jedi101/mailnotifier/README.md

# Mailnotifier

## What is Mailnotifier?
Mailnotifier is a smart mailbox extension that notifies you when you get mail.

### For documentation head over to our:
### [Mailnotifier documentation](https://iot-lab-minden.github.io/mailnotifier/)
