jedi101/mailnotifier/docs/_coverpage.md

# Mailnotifier
### ... make postboxes smart again ...
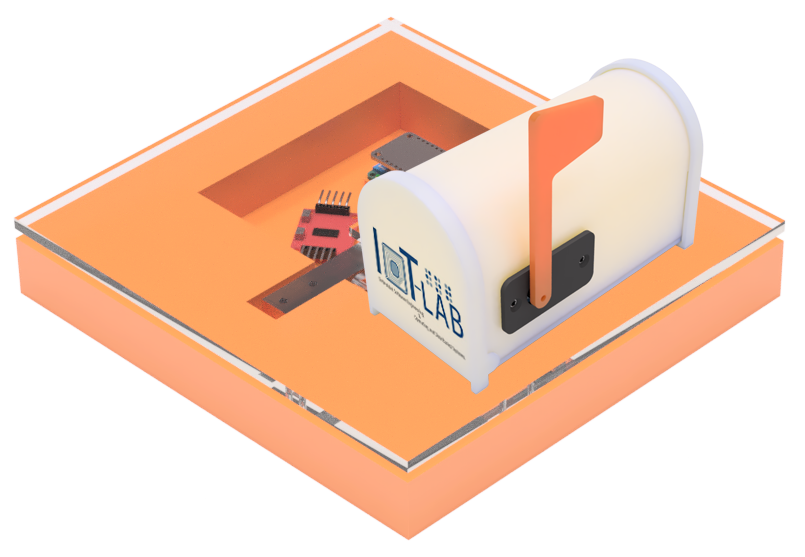
[picture p1: docs/images/coverimage_small.png]


[Overview](#main)
[Used Hardware](https://iot-lab-minden.github.io/mailnotifier/#/?id=used-hardware)
[GitHub](https://github.com/IoT-Lab-Minden/mailnotifier)
