jedi101/mailnotifier/docs/Diagrams/RequirementsDiagram.pdf

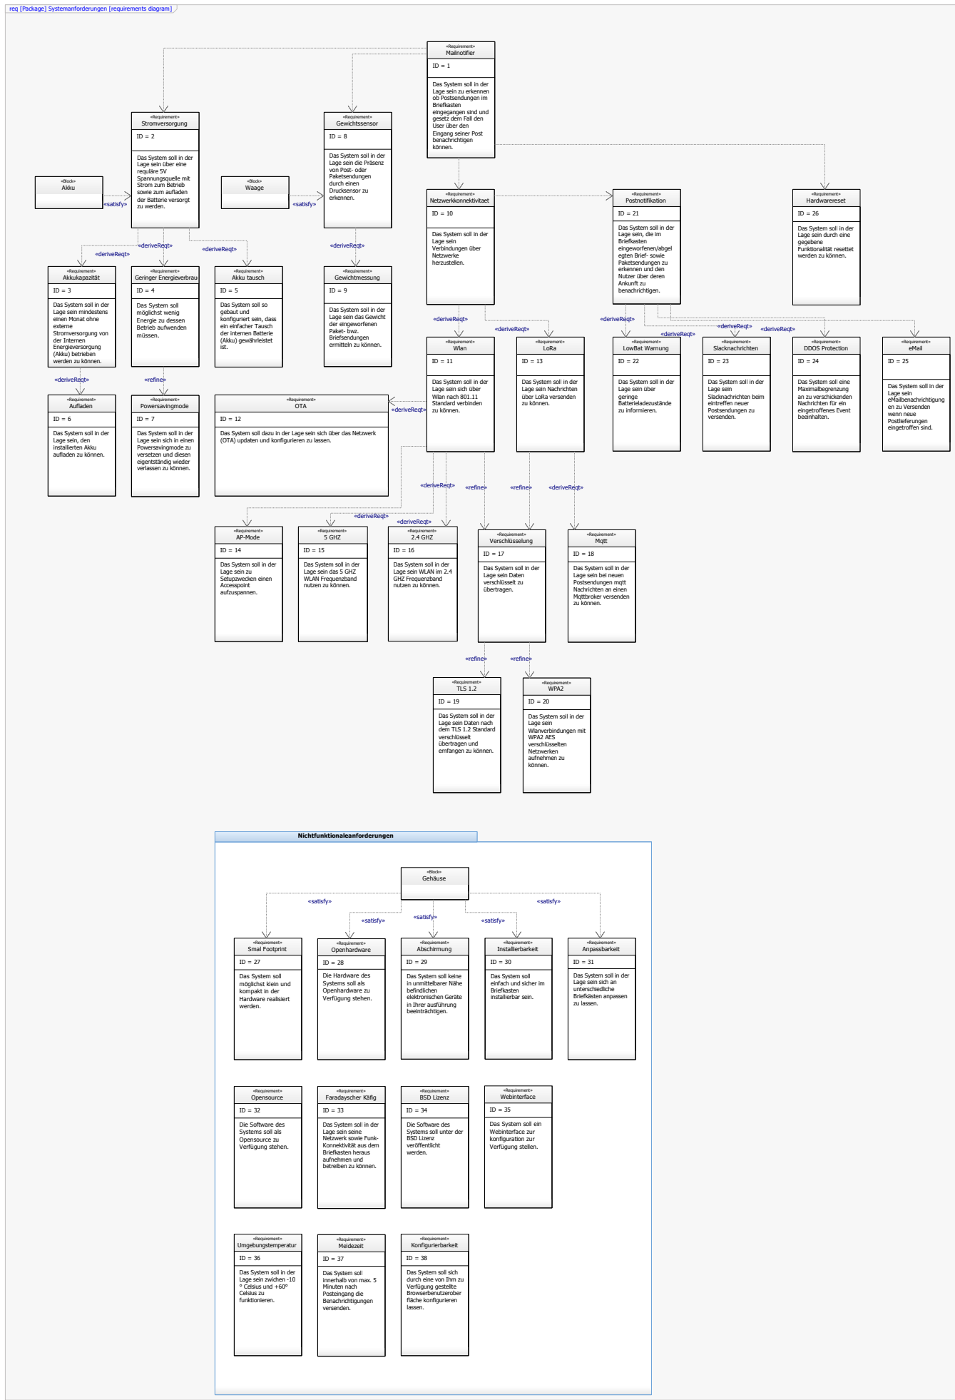
[picture p2: figure]
req [Package] Systemanforderungen [requirements diagram]; Postnotifikation; «Requirement»; Das System soll in der Lage sein, die im Briefkasten eingeworfenen/abgel egten Brief- sowie Paketsendungen zu erkennen und den Nutzer über deren Ankunft zu benachrichtigen.; Nichtfunktionaleanforderungen; Openhardware; Die Hardware des Systems soll als Openhardware zu Verfügung stehen.; Smal Footprint; Das System soll möglichst klein und kompakt in der Hardware realisiert werden.; Abschirmung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

Das System soll dazu in der Lage sein sich über das Netzwerk (OTA) updaten und konfigurieren zu lassen.
