jedi101/mailnotifier/docs/datasheets/feather_fabprint.png

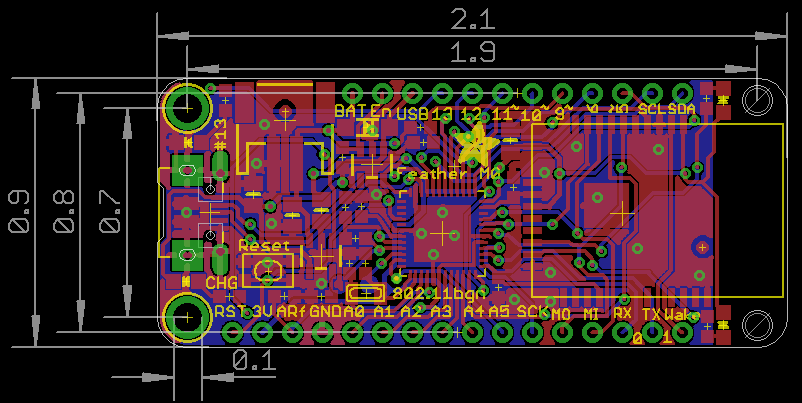
docs/datasheets/feather_fabprint.png
