jedi101/mailnotifier/docs/images/Adafruit-Feather-M0-WiFi---.png

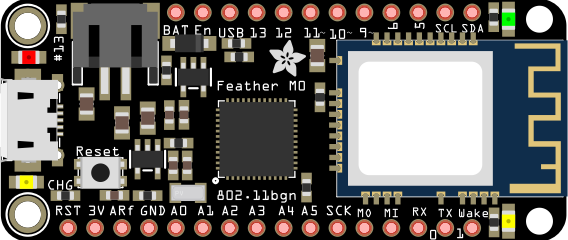
docs/images/Adafruit-Feather-M0-WiFi---.png
