jedi101/mailnotifier/docs/images/coverimage.png

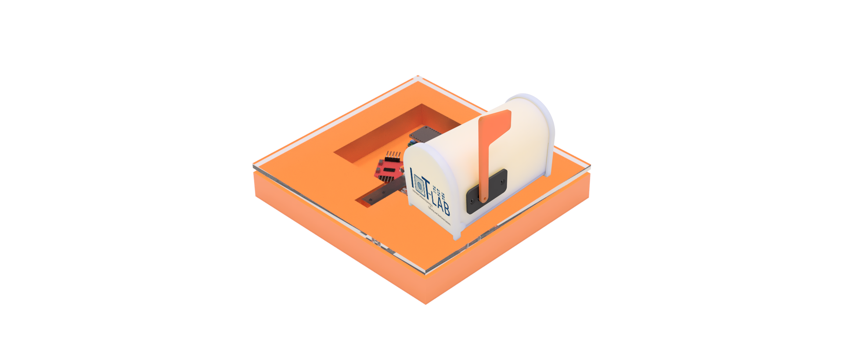
docs/images/coverimage.png
