jedi101/mailnotifier/docs/images/Download3.png

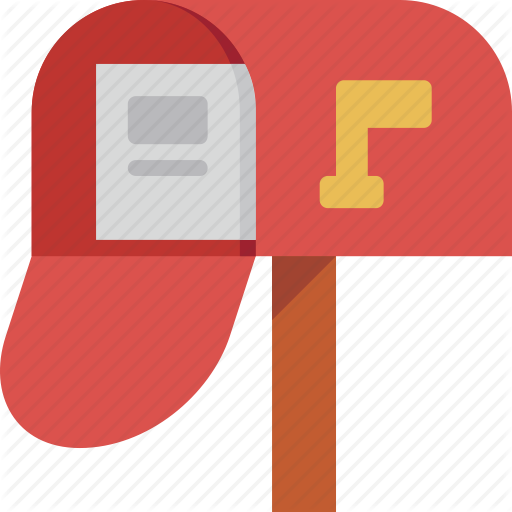
docs/images/Download3.png
