jedi101/mailnotifier/docs/images/HX711_Load_cell_amplifier.png

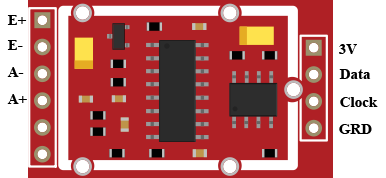
docs/images/HX711_Load_cell_amplifier.png
