jedi101/mailnotifier/docs/images/LoadCell.png

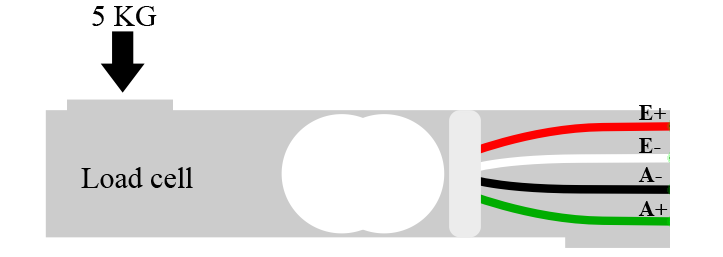
docs/images/LoadCell.png
