jedi101/mailnotifier/docs/images/mailnotifier_receiver.png

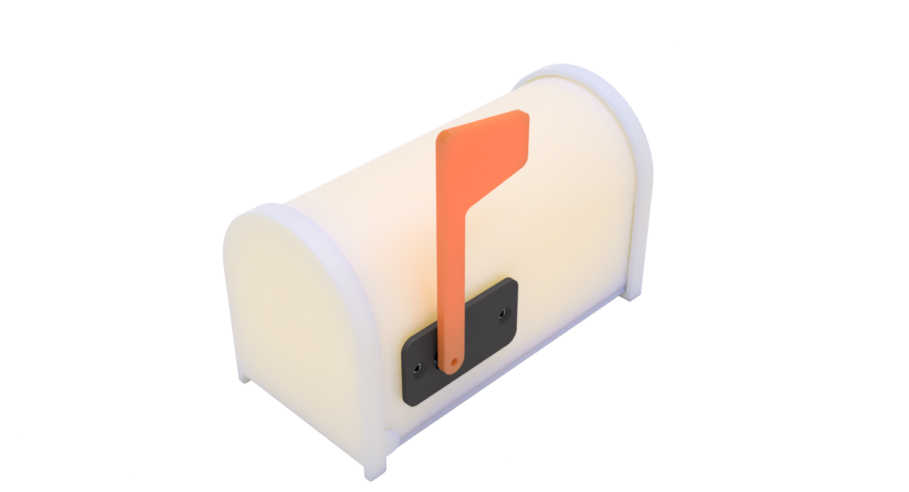
docs/images/mailnotifier_receiver.png
