jedi101/mailnotifier/docs/images/mailnotifierAnsicht1.png

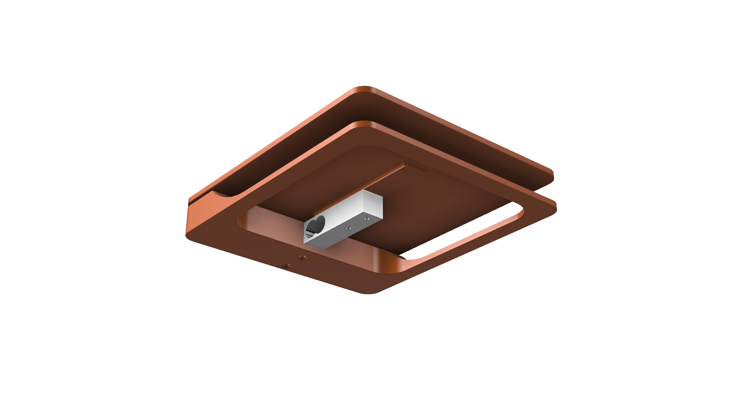
docs/images/mailnotifierAnsicht1.png
