jedi101/mailnotifier/docs/images/mailnotifierAnsichtRechts.png

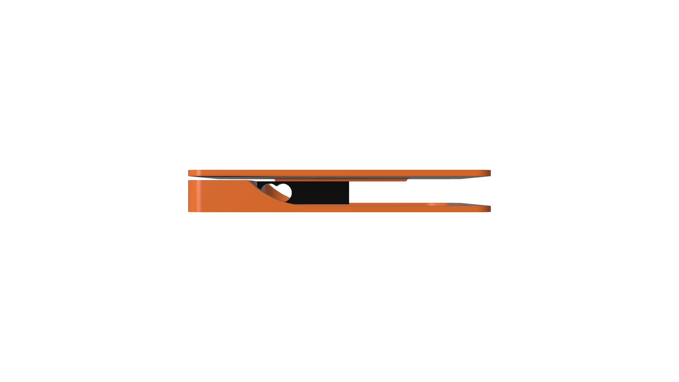
docs/images/mailnotifierAnsichtRechts.png
