jedi101/mailnotifier/docs/images/receiverMailBoxanimated.gif

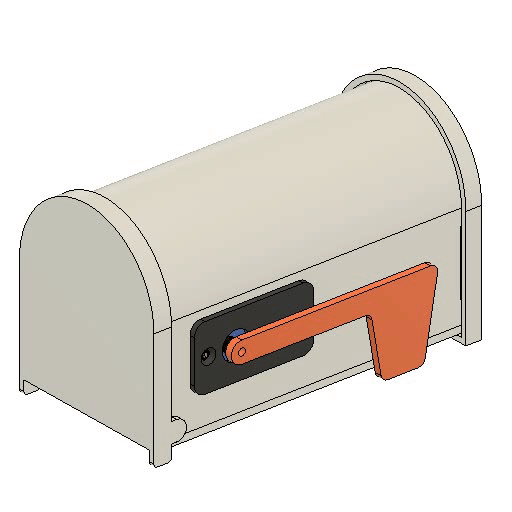
docs/images/receiverMailBoxanimated.gif
