jedi101/mailnotifier/docs/images/transmitter_render.png

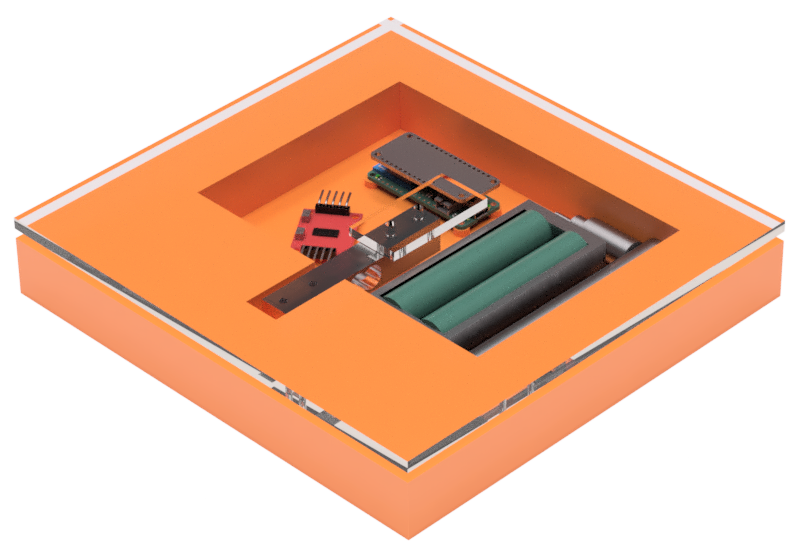
docs/images/transmitter_render.png
