jedi101/mailnotifier/docs/images/Receiver_wiring_schema2.png

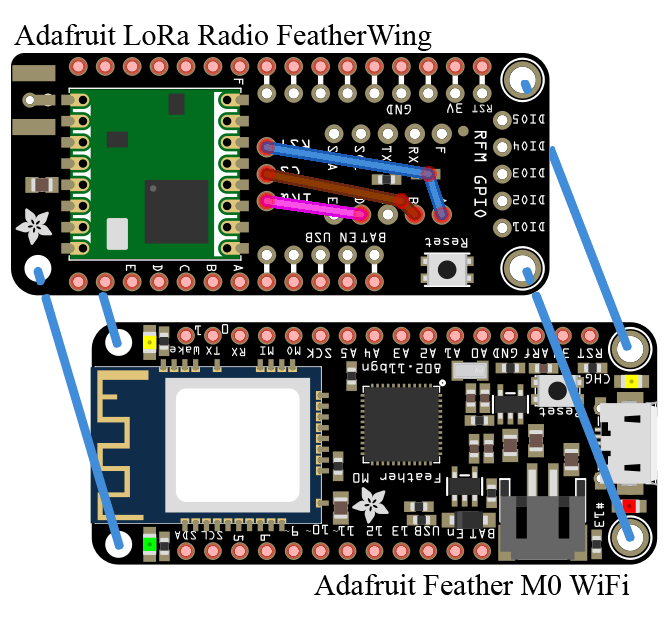
docs/images/Receiver_wiring_schema2.png
