jedi101/mailnotifier/docs/images/wiring_schema2.png

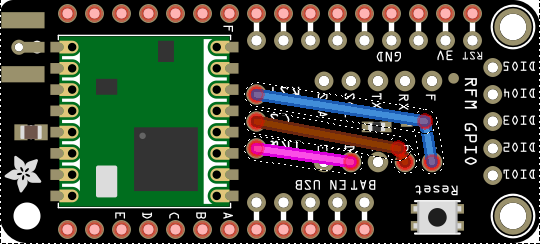
docs/images/wiring_schema2.png
