jedi101/mailnotifier/docs/images/wiring_schema_base.png

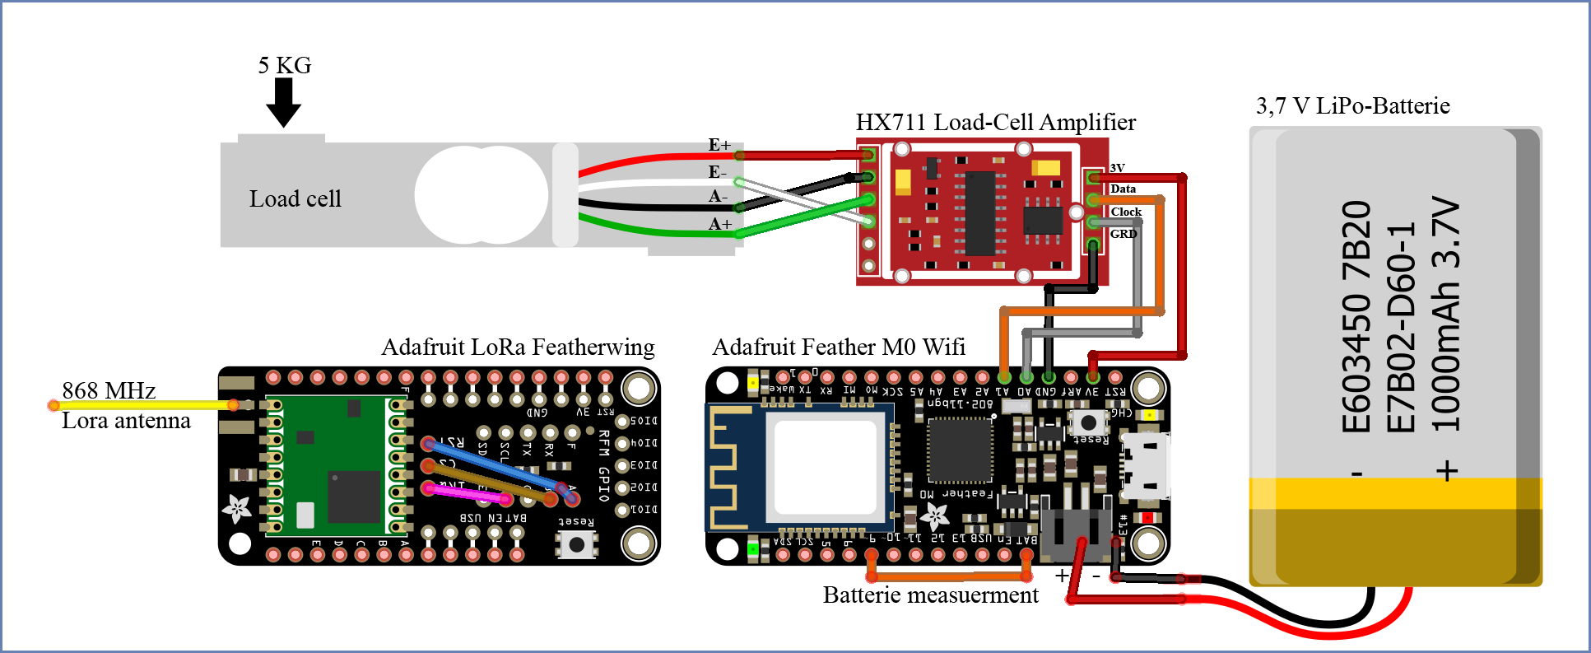
docs/images/wiring_schema_base.png
